TurboTemple/AFR-guage/docs/screens/chart.png

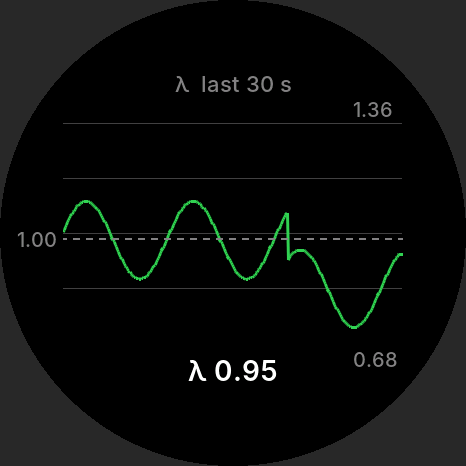
docs/screens/chart.png
