TurboTemple/AFR-guage/docs/screens/ready_after.png

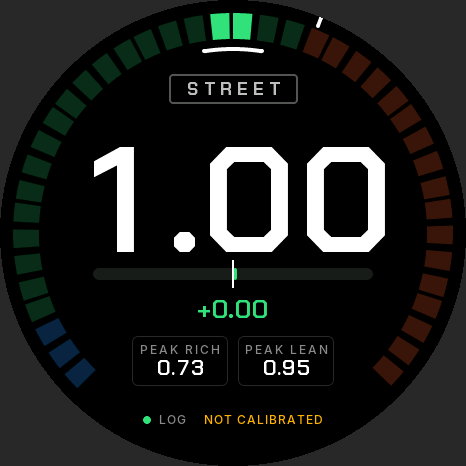
docs/screens/ready_after.png
