TurboTemple/AFR-guage/docs/screens/service.png

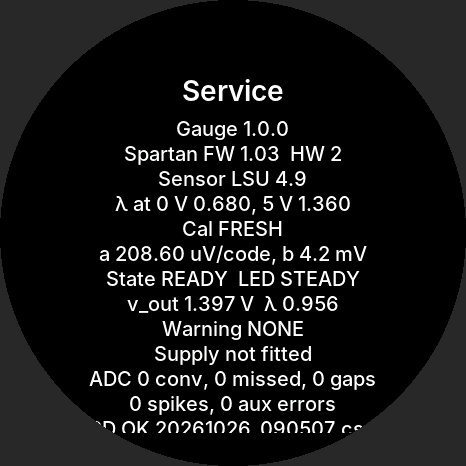
docs/screens/service.png
