TurboTemple/AFR-guage/docs/screens/warming.png

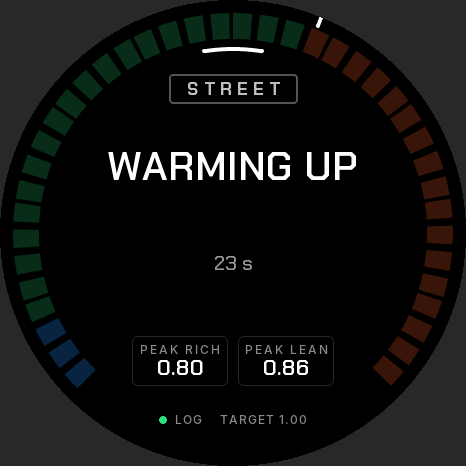
docs/screens/warming.png
