TurboTemple/AFR-guage/(commit log)

2026-10-26 Build the wideband AFR gauge firmware from the technical spec
    ESP-IDF v5.5.5 project for the Waveshare ESP32-S3-Touch-AMOLED-1.75 reading
    a Spartan 3 Lite v2 through an ADS1115:
    - afr_core: hardware-free signal chain (conversion, sequencer calibration,
    LED decoder, state machine, peaks and warnings, smoothing, log format),
    with 85 host Unity tests
    - drivers for the ADS1115, Spartan UART, AXP2101 and PCF85063; microSD
    logger with 1 s fsync and partial-row repair; NVS settings
    - LVGL 9 UI: main gauge, strip chart, settings, service and clock screens
    - replay tool, simulated-drive log generator, UI preview harness,
    simulated Spartan Arduino sketch, CI for host tests and firmware build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
    [partitions.csv]
2026-10-26 Rename the PCF85063 driver functions to avoid an ESP-IDF symbol clash
    rtc_init is already defined by esp_hw_support, which failed the link.
    Claude-Session: https://claude.ai/code/session_01Y4mJw8T1QzrTrnSKG2rDeo
    [app_main.c, rtc_pcf85063.c, rtc_pcf85063.h]
2026-10-26 Make the gauge race-grade: continuous differential sampling and load-aware alarms
    Measurement:
    - Second ADS1115 (0x49) takes the LED, TPS and supply, so the lambda ADS1115
    runs continuously at 860 SPS, differential against a ground-sense wire
    from the Spartan, with ALERT/RDY on GPIO43 timing every conversion.
    - Blocks of 4 are averaged to 215 Hz, with a trimmed mean when a block
    holds a spike; 64-bit timestamps so timers survive past 71 minutes.
    - Spartan held to its 10 ms response mode at every power-up.
    - Every sample is logged (tps and alarm columns); logger queue in PSRAM.
    Alarms (always armed, throttle-aware):
    - LEAN AT LOAD: lambda above the load limit or on the lean rail with t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
2026-10-26 Default the lean-at-load limit to lambda 0.92 for a naturally aspirated engine
    NA petrol makes best power around 0.86-0.88 at full throttle; 0.90 could
    nag a healthy tune, and danger starts around 0.93-0.95. A test now checks a
    tune holding 0.89-0.91 at full throttle never alarms.
    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
2026-10-27 Simplify to a lambda gauge with lean/rich warnings, no throttle input
    Drop the TPS input and the load-aware alarms. The gauge now warns on
    lambda alone: LEAN above 1.05 (or on the lean rail) and RICH below 0.75
    (or on the rich rail), each after 300 ms, all adjustable. Lean flashes
    red, rich amber; nothing latches. Fuel cut on a lift also shows LEAN,
    since there is no throttle signal to tell it apart.
    The measurement chain is unchanged: continuous 860 SPS differential
    lambda on its own ADS1115, RDY-timed, decimated to 215 Hz, start-up
    two-point calibration, every sample logged. The second ADS1115 keeps the
    LED (50 Hz) and supply sense.
    Peaks count every READY sample again. The log drops the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
2026-10-27 Add race mode, a 5-minute lean ring and a race-dash main screen
    Race mode (double-tap to toggle, saved): lean warning above lambda 0.92
    after 15 ms, target 0.86, bar zoomed to 0.70-1.05. Street keeps 1.05 after
    300 ms around a 1.00 target. Limits are from NA LS practice: 0.83-0.87 at
    full throttle, caution from 0.90-0.92, concern from 0.93-0.95. A mode
    switch re-arms the warnings. Simulated chain: 20 ms from the Spartan
    crossing the limit to the warning; the UI polls at 100 Hz and redraws the
    moment a warning starts.
    Lean ring: after a lean warning that comes back to safe, a red ring for
    5 minutes. Only a lean-out counts: it must start from a safe reading,
    never reach the lean rail (fuel cu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
2026-10-27 Add the install guide: shopping list, wiring, fitting and HP Tuners logging
    docs/INSTALL.md covers the parts list with UK prices, flashing the CI
    firmware, building the two-ADC interface board pin by pin, a bench test,
    sensor placement and torque, the Spartan and gauge car wiring (wire
    colours from the Spartan 3 Lite v2 manual), first start, and logging the
    same green wire in VCM Scanner through a PROLINK+ (wiring, transform
    0 V = 0.68 / 5 V = 1.36, cross-check with the gauge's ADC check).
    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
